adafruit/Adafruit-High-Power-Infrared-LED-Emitter-PCB/IR STEMMA LED Emitter.brd

## EAGLE design IR STEMMA LED Emitter.brd (2022-11-08)

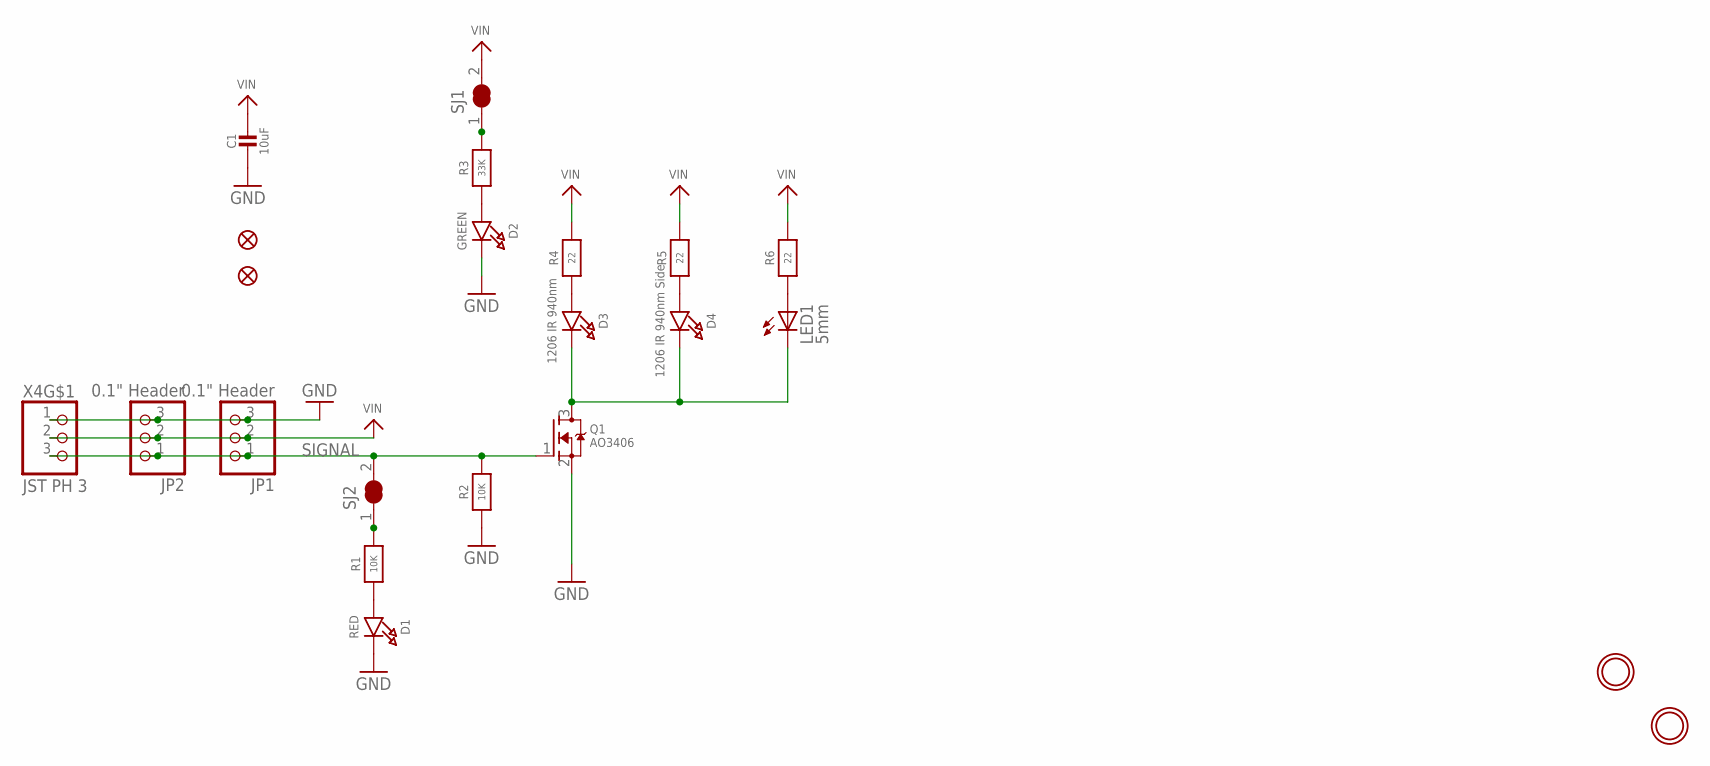
[picture p2: schematic IR STEMMA LED Emitter.sch]

Parts:
C1: 10uF; 0805-NO
D1: RED; CHIPLED_0603_NOOUTLINE
D2: GREEN; CHIPLED_0603_NOOUTLINE
D3: 1206 IR 940nm; CHIPLED_1206
D4: 1206 IR 940nm Side; LED_1206_SIDE
FID2, FID3: FIDUCIAL_1MM
JP1: 0.1" Header; 1X03_OVAL
JP2: 0.1" Header; 1X03_ROUND
LED1: 5mm; LED5MM
Q1: AO3406; SOT23-WIDE
R1, R2: 10K; 0603-NO
R3: 33K; 0603-NO
R4, R5, R6: 22; 0603-NO
SJ1, SJ2: SOLDERJUMPER_CLOSED; SOLDERJUMPER_CLOSEDWIRE
U$1, U$8: MOUNTINGHOLE2.5; MOUNTINGHOLE_2.5_PLATED
X4: JST PH 3; JSTPH3

Connections:
GND: C1.2, D1.C, D2.C, JP1.3, JP2.3, Q1.2 (S), R2.1, X4.1
unnamed: R3.2, SJ1.1
unnamed: D1.A, R1.1
unnamed: R1.2, SJ2.1
unnamed: D3.C, D4.C, LED1.K (C), Q1.3 (D)
unnamed: D3.A, R4.1
unnamed: D4.A, R5.1
unnamed: LED1.A, R6.1
unnamed: D2.A, R3.1
SIGNAL: JP1.1, JP2.1, Q1.1 (G), R2.2, SJ2.2, X4.3
VIN: C1.1, JP1.2, JP2.2, R4.2, R5.2, R6.2, SJ1.2, X4.2

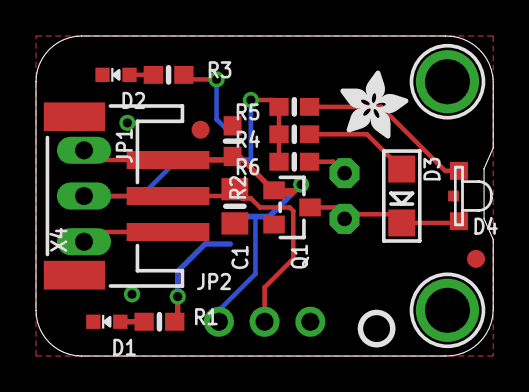
[picture p3: board IR STEMMA LED Emitter.brd from above]

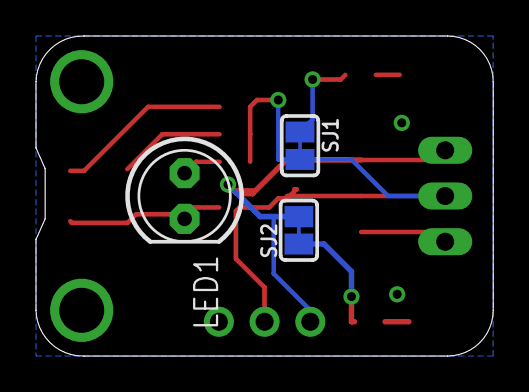
[picture p4: board IR STEMMA LED Emitter.brd from below]

Board: 2 copper layers, 25.4 x 17.8 mm, 39 parts (14 on the bottom side), 11 nets.

Other parts of the board:
PLABEL0: PLABEL0
PLABEL00: PLABEL00
PLABEL1: PLABEL1
PLABEL2: PLABEL2
PLABEL3: PLABEL3
PLABEL4: PLABEL4
PLABEL5: PLABEL5
PLABEL6: PLABEL6
PLABEL7: PLABEL7
PLABEL8: PLABEL8
PLABEL9: PLABEL9
PLABEL10: PLABEL10
PLABEL11: PLABEL11
PLABEL13: PLABEL13
PLABEL14: PLABEL14
U$5: PCBFEAT-REV-040
U$10: ADAFRUIT_3.5MM
